elliottohmiller/tombus_3.0/README.md

# tombus_3.0
A barebones noisemaker with a focus on intuitive controls. 
tombus_3 0_model
