elliottohmiller/tombus_3.0/CAD outputs/tombus_box_drawing.pdf

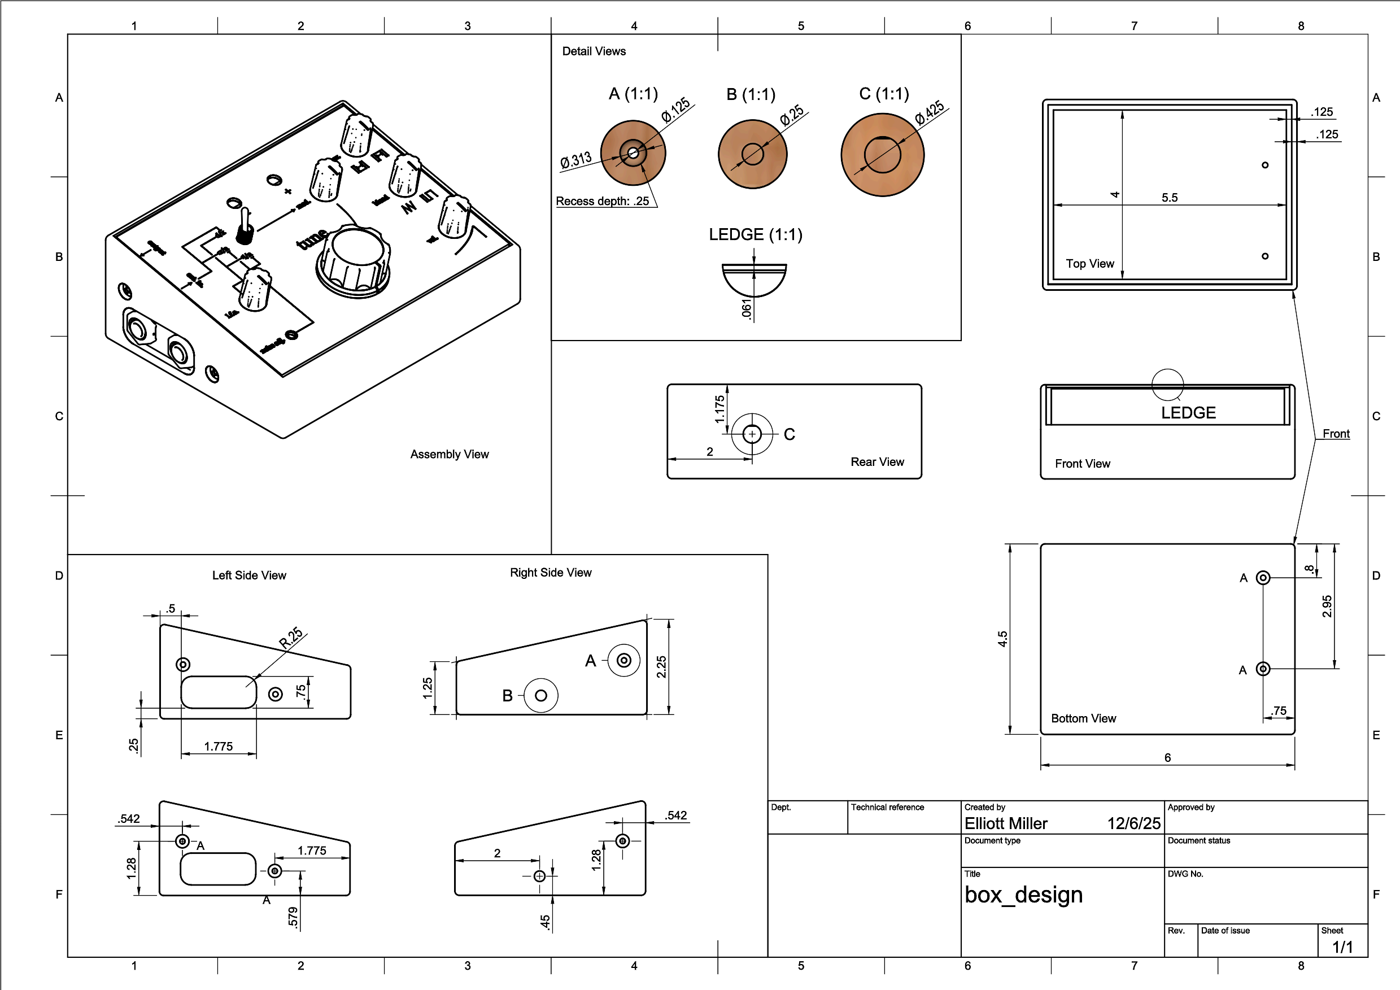
[picture p1: page 1]
