elliottohmiller/tombus_3.0/appNotes_and_dataSheets/Screenshot 2025-11-16 at 7.06.22 PM.png

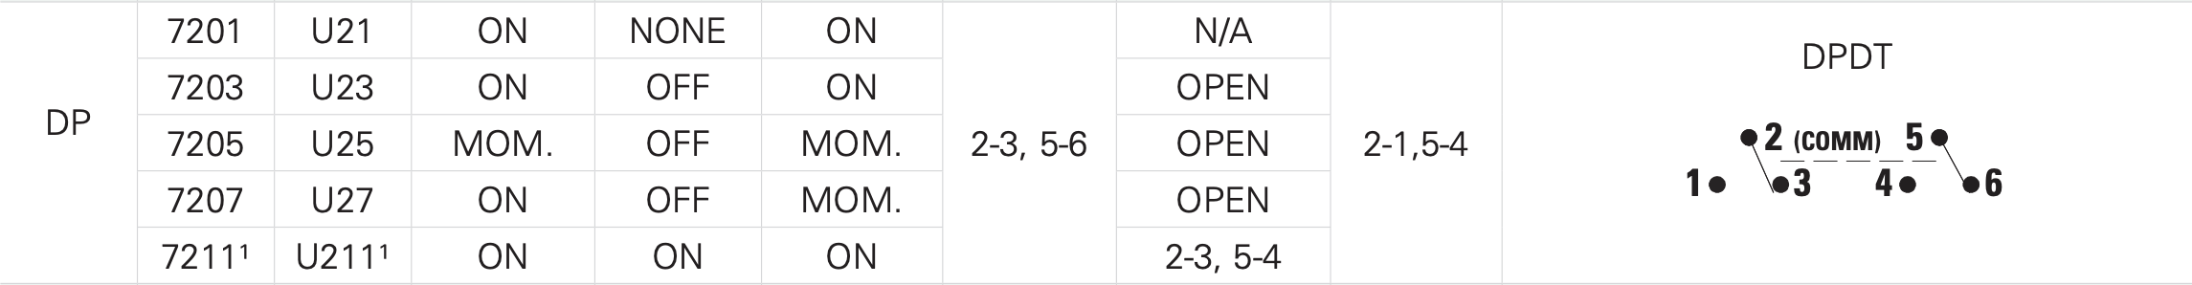
appNotes_and_dataSheets/Screenshot 2025-11-16 at 7.06.22 PM.png
