elliottohmiller/tombus_3.0/CAD outputs/tombus_3.0_model.png

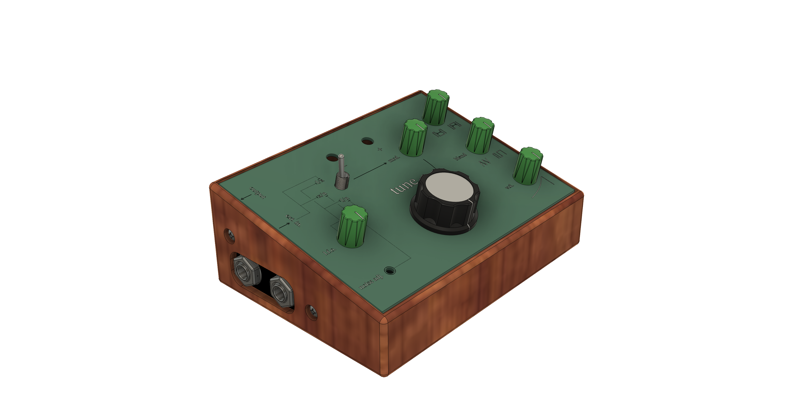
CAD outputs/tombus_3.0_model.png
