elliottohmiller/tombus_3.0/projectNotes/initial board constraints.png

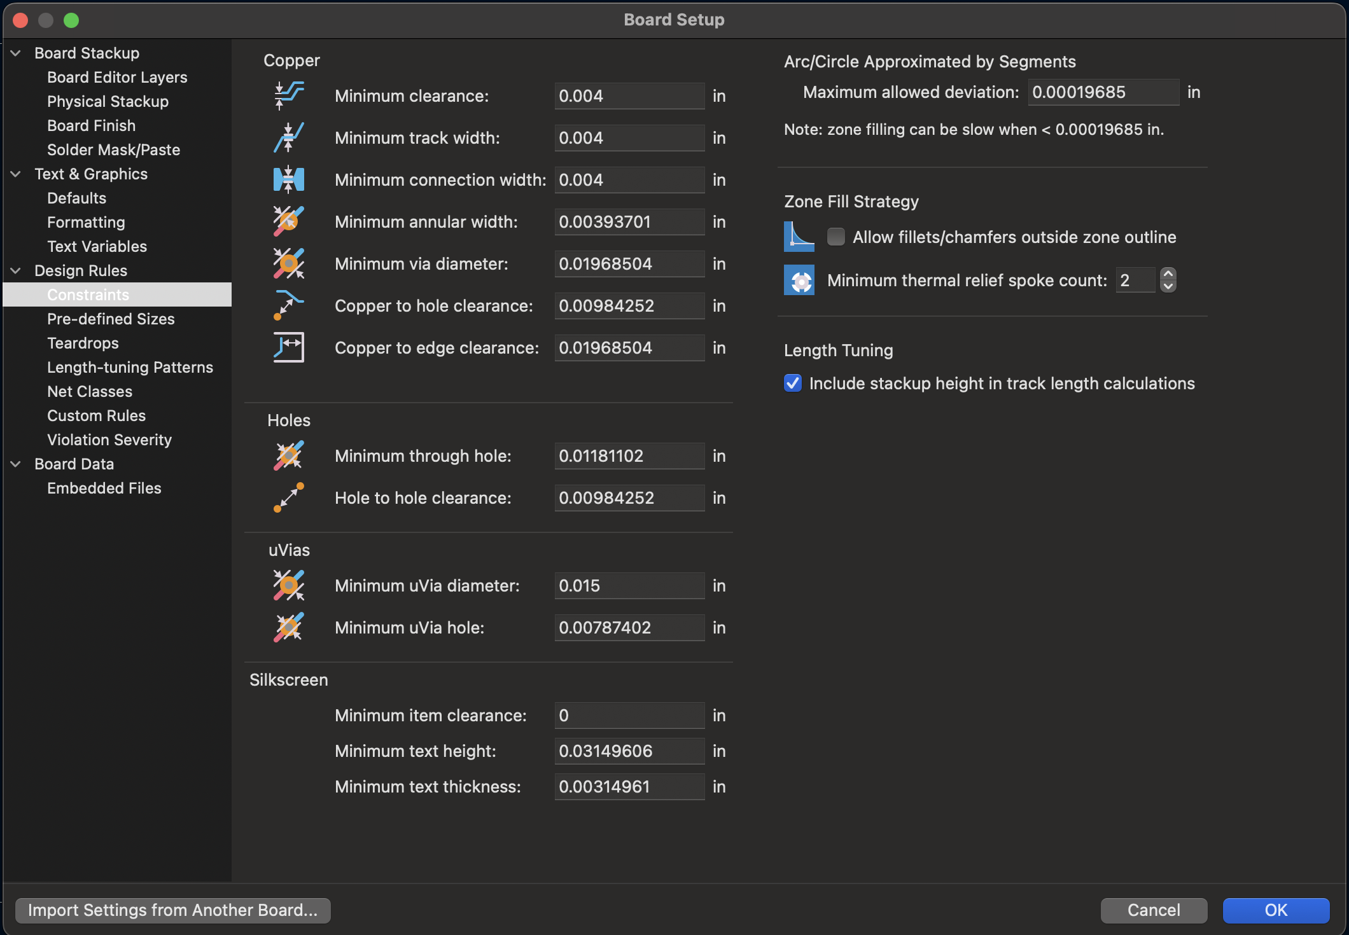
projectNotes/initial board constraints.png
