elliottohmiller/tombus_3.0/pdf_schematics/controlboard_init.pdf

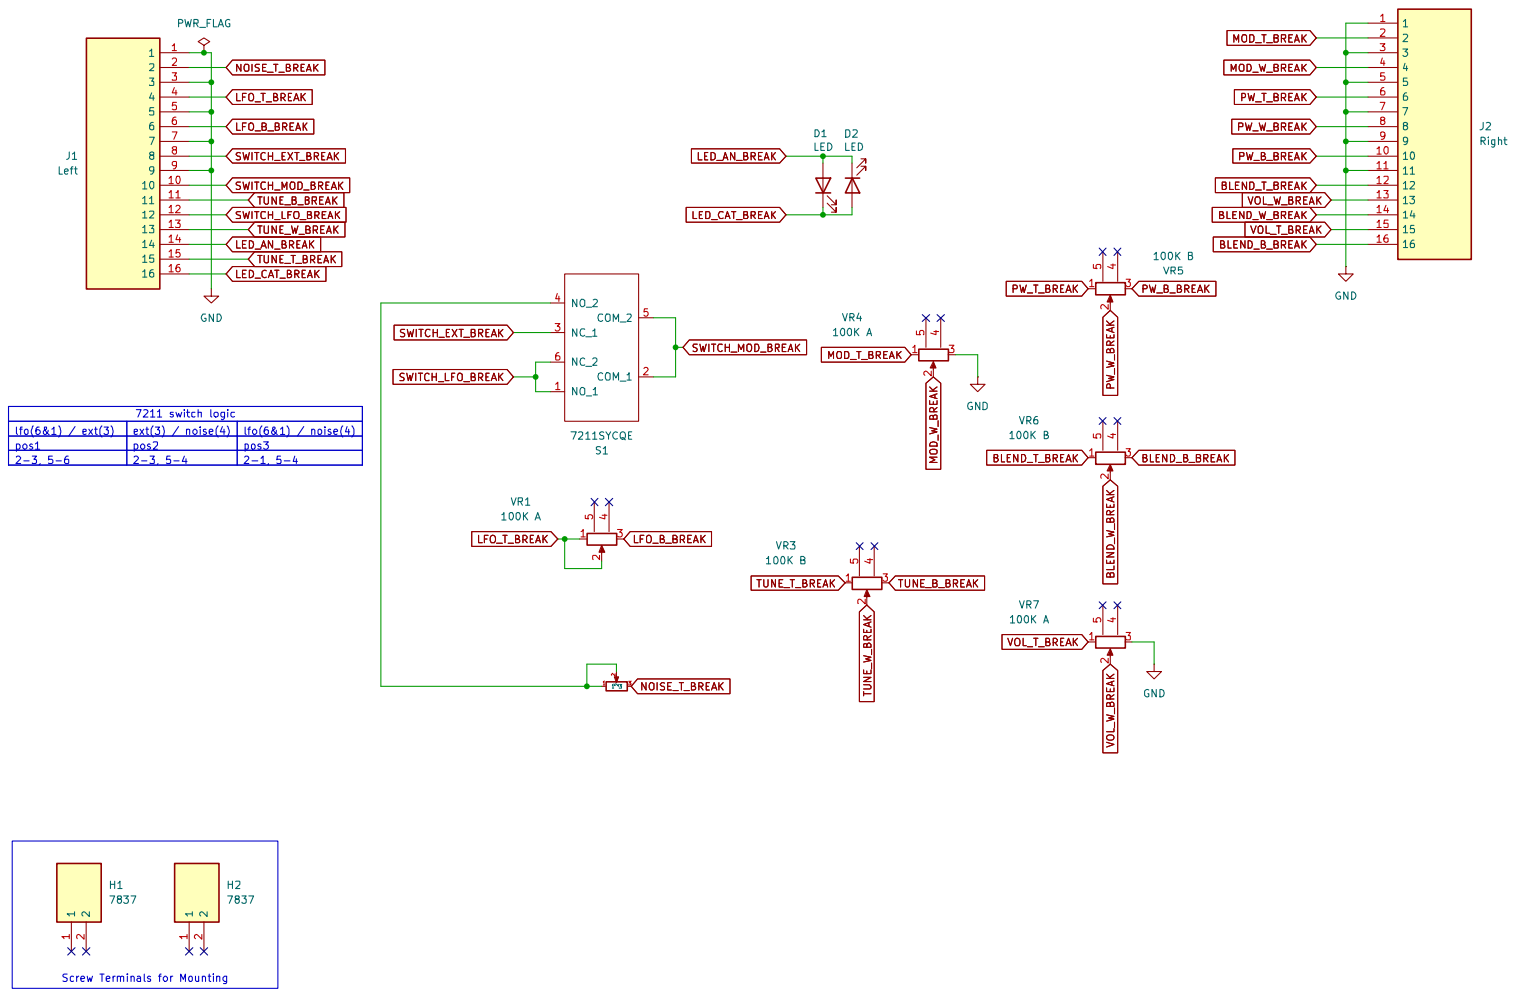
[picture p5: page 1]
