elliottohmiller/tombus_3.0/pdf_schematics/controlboard_pcb_init.pdf

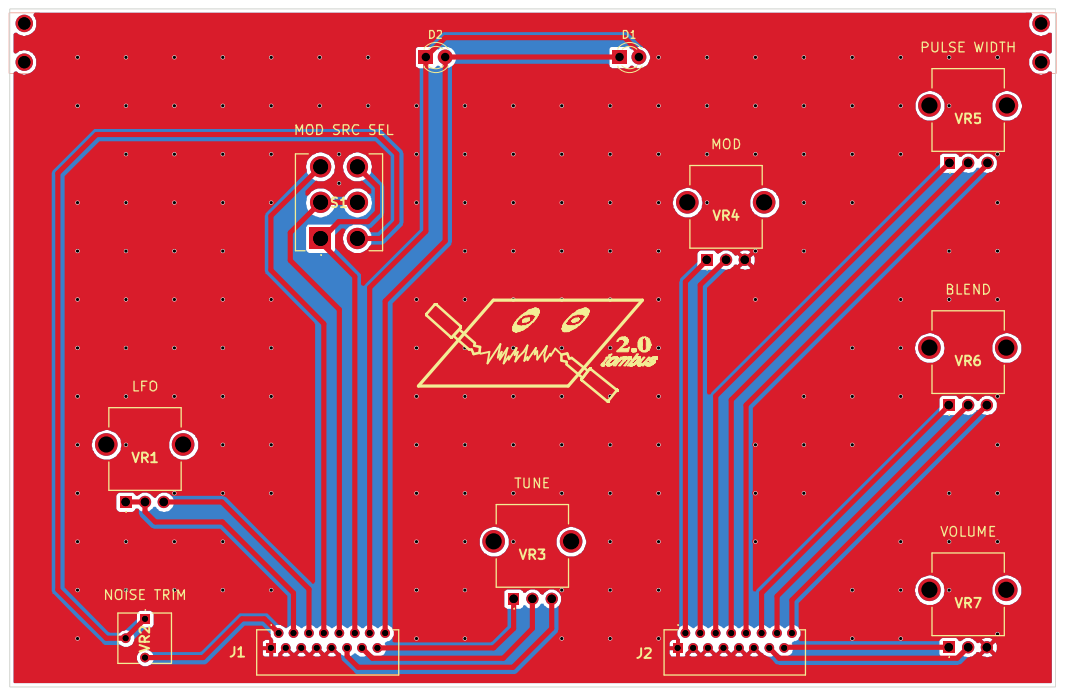
[picture p6: page 1]
