elliottohmiller/tombus_3.0/pdf_schematics/motherboard_pcb_init.pdf

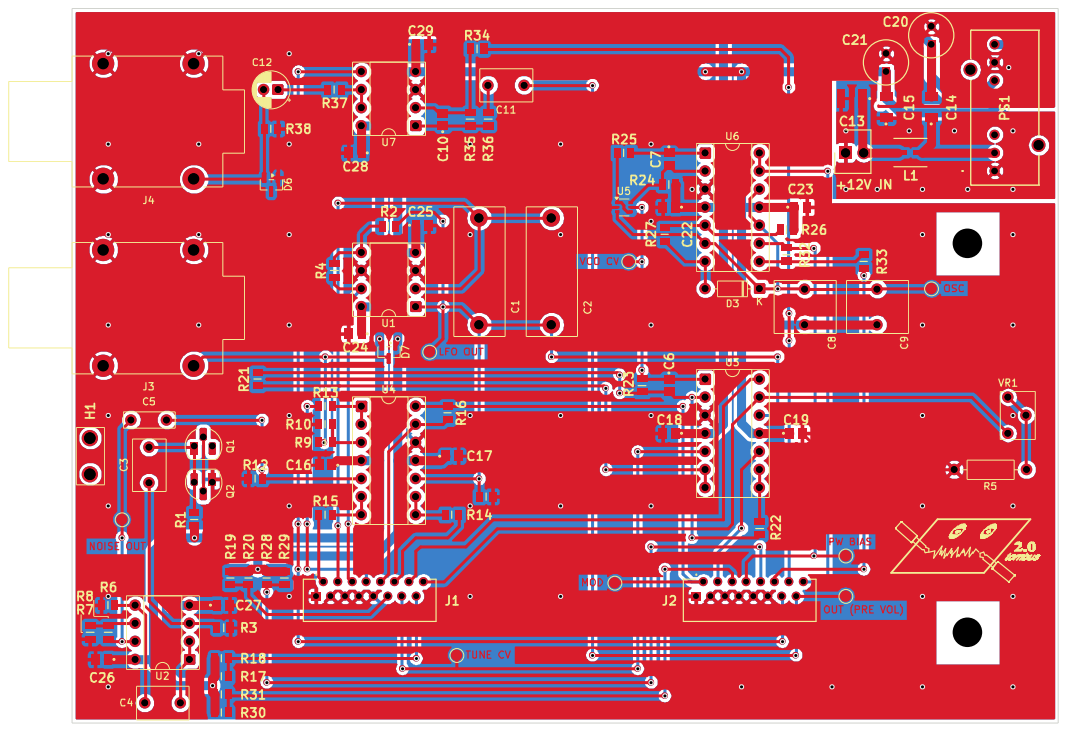
[picture p12: page 1]
