elliottohmiller/tombus_3.0/CAD outputs/tombus_2.0_front_panel.pdf

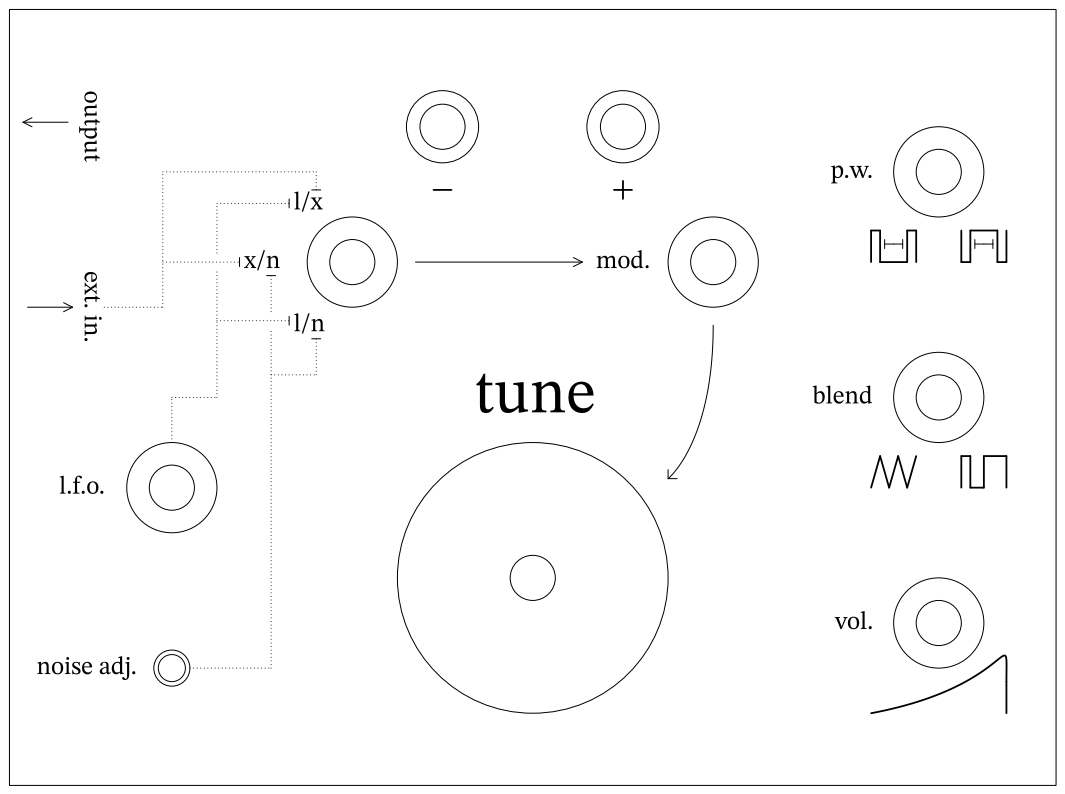
[picture p13: page 1]
