elliottohmiller/tombus_3.0/motherboard/motherboard.kicad_pcb

## KiCad design motherboard/motherboard.kicad_pcb (2026-02-08)

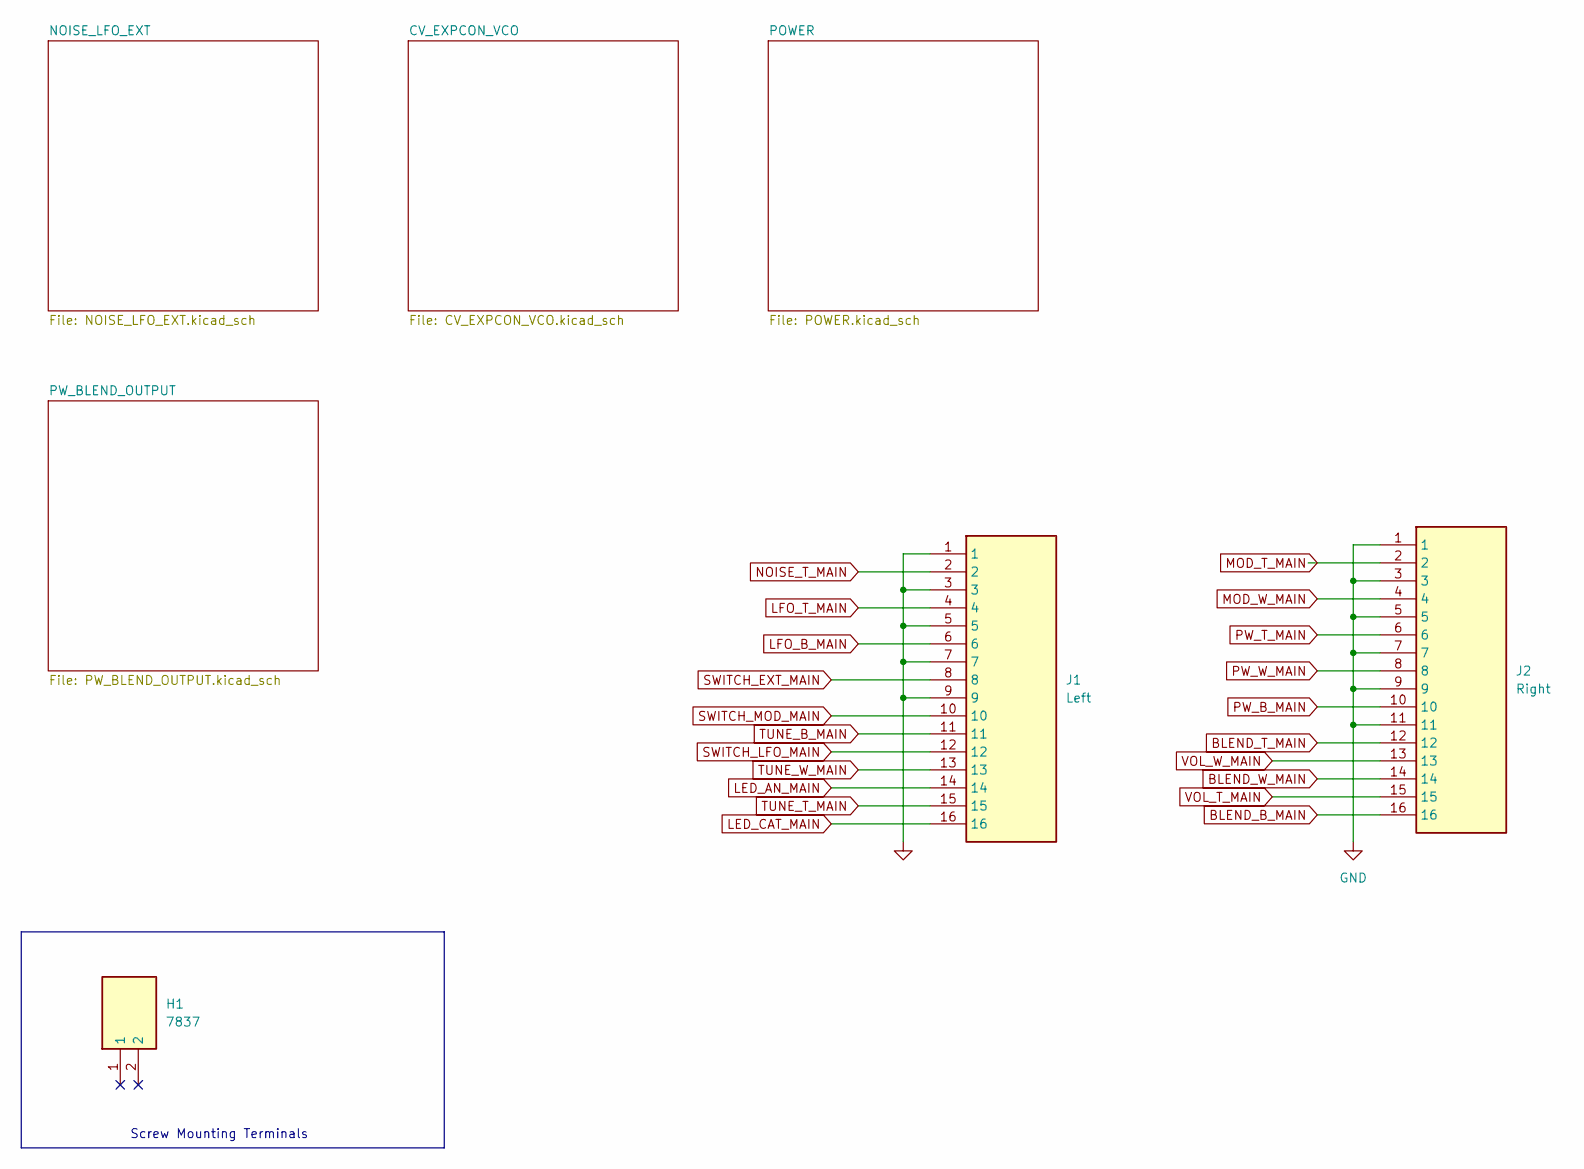
[picture p14: schematic motherboard.kicad_sch]

Parts:
H1: 7837; Mouser Part Number 534-7837
J1: Left; HLW16R2C7LF; Mouser Part Number 649-HLW16R-2C7LF
J2: Right; HLW16R2C7LF; Mouser Part Number 649-HLW16R-2C7LF

Connections:
BLEND_B_MAIN: J2.16; also elsewhere on the board
BLEND_T_MAIN: J2.12; also elsewhere on the board
BLEND_W_MAIN: J2.14; also elsewhere on the board
GND: J1.1, J1.3, J1.5, J1.7, J1.9, J2.1, J2.3, J2.5, J2.7, J2.9, J2.11; also elsewhere on the board
LED_AN_MAIN: J1.14; also elsewhere on the board
LED_CAT_MAIN: J1.16; also elsewhere on the board
LFO_B_MAIN: J1.6; also elsewhere on the board
LFO_T_MAIN: J1.4; also elsewhere on the board
MOD_T_MAIN: J2.2; also elsewhere on the board
MOD_W_MAIN: J2.4; also elsewhere on the board
NOISE_T_MAIN: J1.2; also elsewhere on the board
PW_B_MAIN: J2.10; also elsewhere on the board
PW_T_MAIN: J2.6; also elsewhere on the board
PW_W_MAIN: J2.8; also elsewhere on the board
SWITCH_EXT_MAIN: J1.8; also elsewhere on the board
SWITCH_LFO_MAIN: J1.12; also elsewhere on the board
SWITCH_MOD_MAIN: J1.10; also elsewhere on the board
TUNE_B_MAIN: J1.11; also elsewhere on the board
TUNE_T_MAIN: J1.15; also elsewhere on the board
TUNE_W_MAIN: J1.13; also elsewhere on the board
VOL_T_MAIN: J2.15; also elsewhere on the board
VOL_W_MAIN: J2.13; also elsewhere on the board

Notes on the sheet:
Screw Mounting Terminals

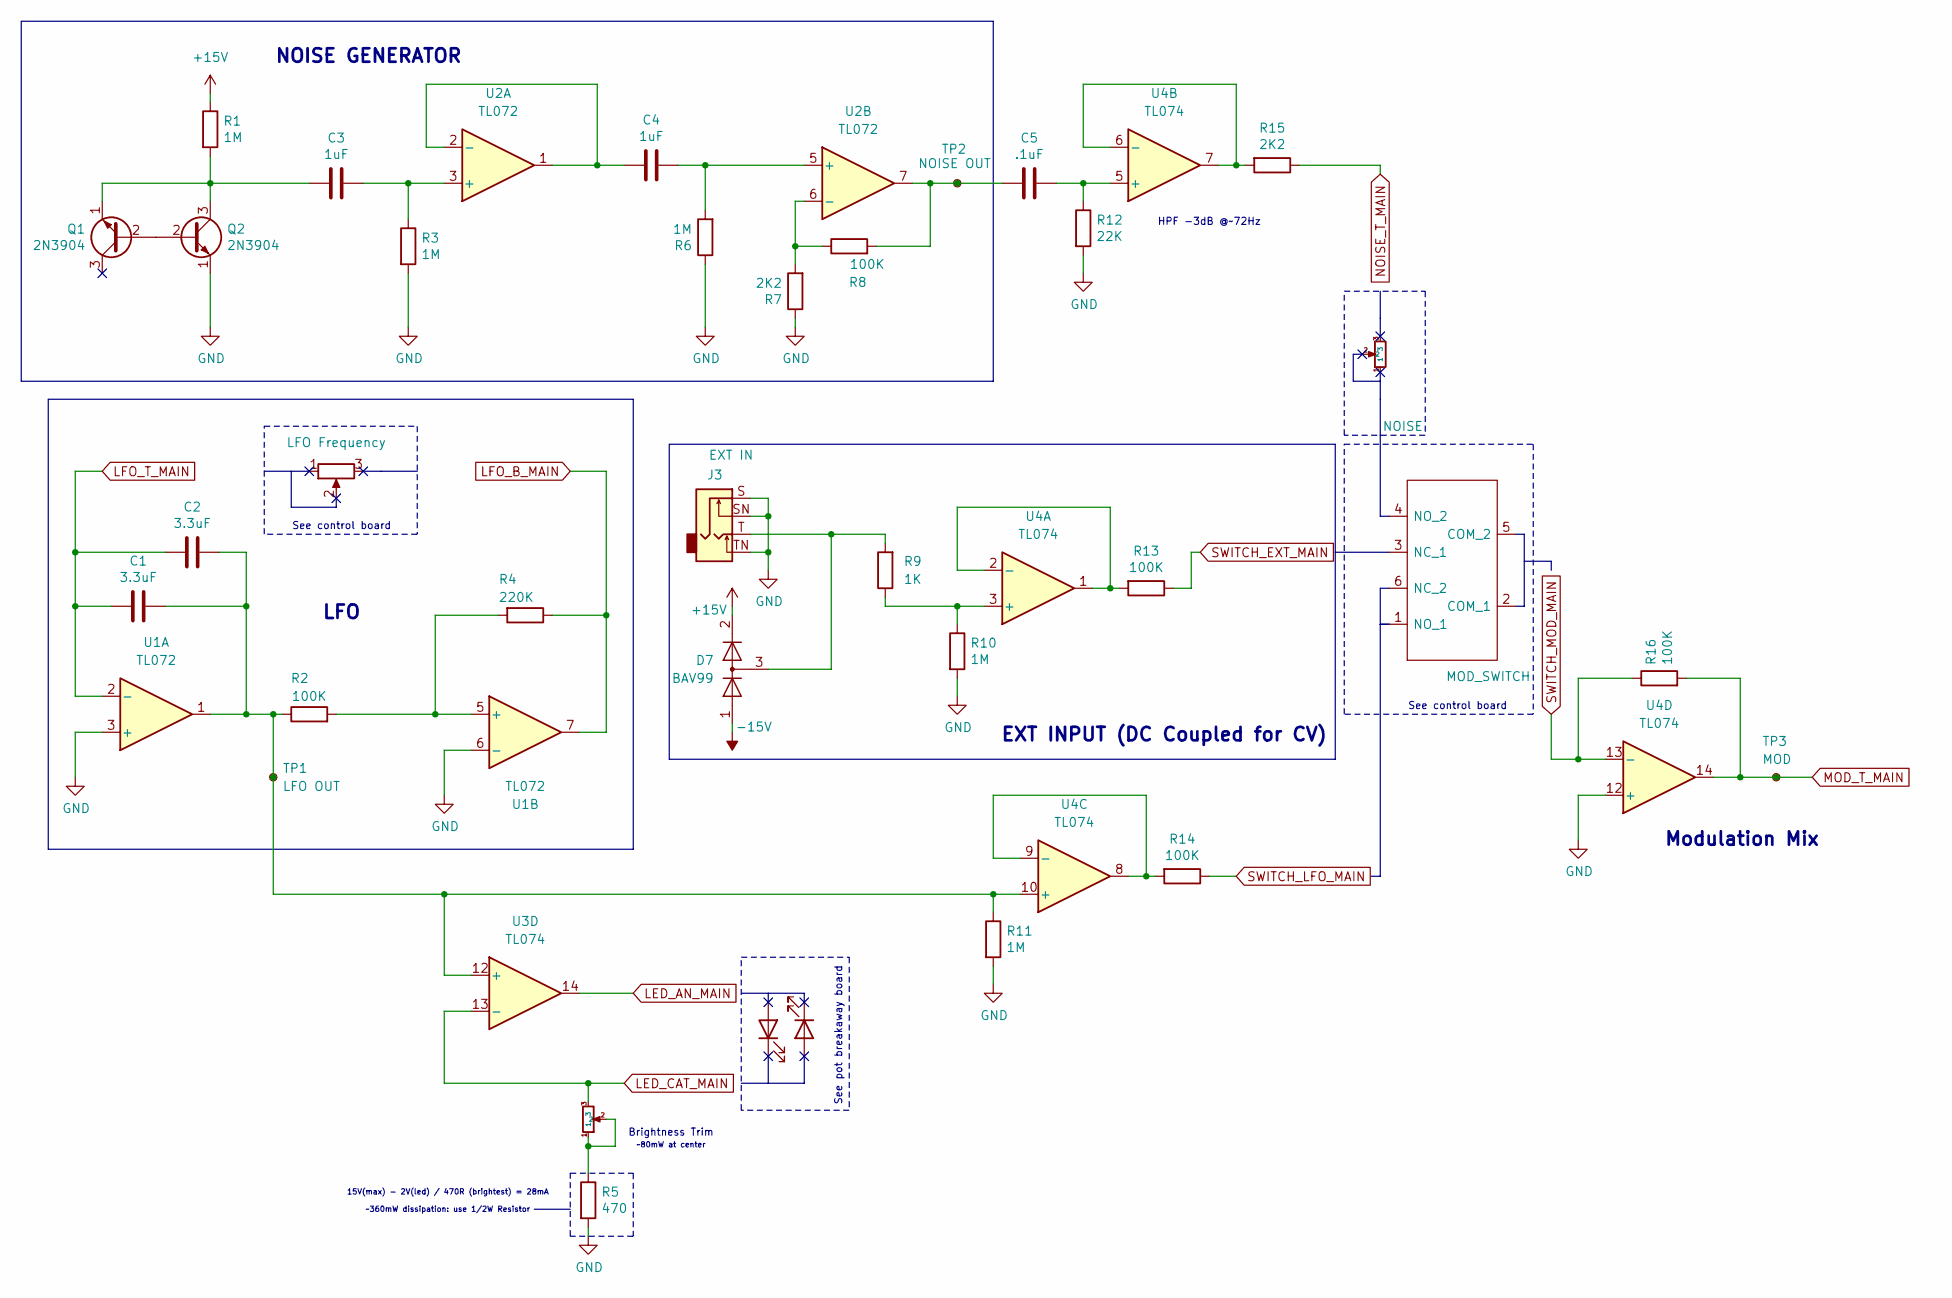
[picture p15: schematic NOISE_LFO_EXT.kicad_sch]

Parts:
C1, C2: 3.3uF; C_Rect_L18.0mm_W7.0mm_P15.00mm_FKS3_FKP3
C3, C4: 1uF; C_Rect_L7.2mm_W4.5mm_P5.00mm_FKS2_FKP2_MKS2_MKP2
C5: .1uF; C_Rect_L7.0mm_W2.0mm_P5.00mm
D1, D2: LFO F
D7: BAV99; SOT-23
J3: EXT IN; Jack_6.35mm_Neutrik_NMJ4HFD2_Horizontal
Q1, Q2: 2N3904; TO-92_HandSolder
R1, R3, R6, R10, R11: 1M; RESC2012X60N
R2, R8, R13, R14, R16: 100K; RESC2012X60N
R4: 220K; RESC2012X60N
R5: 470; R_Axial_DIN0207_L6.3mm_D2.5mm_P10.16mm_Horizontal
R7, R15: 2K2; RESC2012X60N
R9: 1K; RESC2012X60N
R12: 22K; RESC2012X60N
RV1: LFO Frequency
S1: MOD_SWITCH; 7211SYCQE; Mouser Part Number 611-7211-002
TP1: LFO OUT; TestPoint_Pad_D1.5mm
TP2: NOISE OUT; TestPoint_Pad_D1.5mm
TP3: MOD; TestPoint_Pad_D1.5mm
U1, U2: TL072; DIP-8_W7.62mm_Socket
U3, U4: TL074; DIP-14_W7.62mm_Socket
VR1: LED BRIGHTNESS; Potentiometer_Vishay_T73XX_Horizontal; Mouser Part Number 72-T70YP-10K
VR2: NOISE; T73YP103KT20; Mouser Part Number 72-T70YP-10K

Connections:
+15V: D7.2 (A), R1.1; also elsewhere on the board
-15V: D7.1 (K); also elsewhere on the board
GND: J3.S, J3.SN, J3.TN, Q2.1 (E), R3.2, R5.2, R6.1, R7.1, R10.2, R11.2, R12.2, U1.3 (+), U1.6 (-), U4.12 (+); also elsewhere on the board
LED_AN_MAIN: U3.14; also elsewhere on the board
LED_CAT_MAIN: U3.13 (-), VR1.3; also elsewhere on the board
LFO_B_MAIN: R4.1, U1.7; also elsewhere on the board
LFO_T_MAIN: C1.2, C2.2, U1.2 (-); also elsewhere on the board
MOD_T_MAIN: R16.2, TP3.1, U4.14; also elsewhere on the board
NOISE_T_MAIN: R15.1; also elsewhere on the board
unnamed: C5.2, R8.2, TP2.1, U2.7
unnamed: D7.3 (K), J3.T, R9.2
unnamed: Q1.2 (B), Q2.2 (B)
unnamed: C3.2, Q1.1 (E), Q2.3 (C), R1.2
unnamed: R5.1, VR1.1, VR1.2
unnamed: R2.2, R4.2, U1.5 (+)
unnamed: C3.1, R3.1, U2.3 (+)
unnamed: C4.2, U2.1, U2.2 (-)
unnamed: C4.1, R6.2, U2.5 (+)
unnamed: R7.2, R8.1, U2.6 (-)
unnamed: C1.1, C2.1, R2.1, R11.1, TP1.1, U1.1, U3.12 (+), U4.10 (+)
unnamed: R9.1, R10.1, U4.3 (+)
unnamed: R13.2, U4.1, U4.2 (-)
unnamed: C5.1, R12.1, U4.5 (+)
unnamed: R15.2, U4.6 (-), U4.7
unnamed: R14.2, U4.8, U4.9 (-)
SWITCH_EXT_MAIN: R13.1; also elsewhere on the board
SWITCH_LFO_MAIN: R14.1; also elsewhere on the board
SWITCH_MOD_MAIN: R16.1, U4.13 (-); also elsewhere on the board

Notes on the sheet:
Brightness Trim
NOISE GENERATOR
LFO
15V(max) - 2V(led) / 470R (brightest) = 28mA ~360mW dissipation: use 1/2W Resistor
See control board
See pot breakaway board
~80mW at center
HPF -3dB @~72Hz
EXT INPUT (DC Coupled for CV)
Modulation Mix

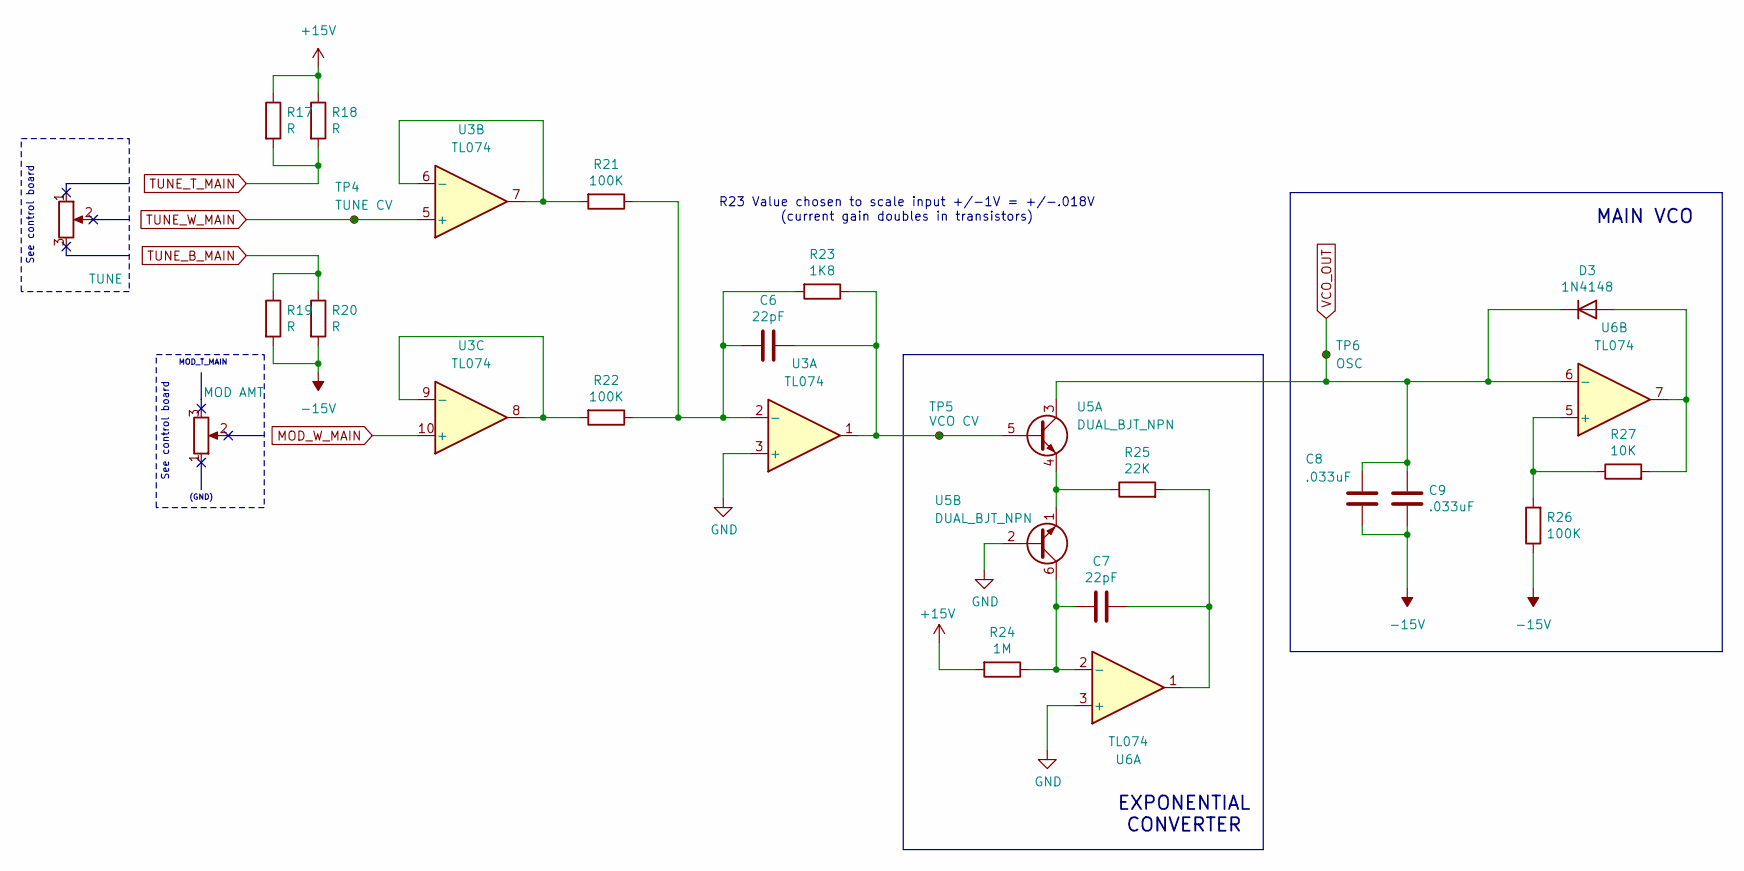
[picture p16: schematic CV_EXPCON_VCO.kicad_sch]

Parts:
C6, C7: 22pF; C0805
C8, C9: .033uF; C_Rect_L7.2mm_W8.5mm_P5.00mm_FKP2_FKP2_MKS2_MKP2
D3: 1N4148; D_DO-35_SOD27_P7.62mm_Horizontal
R17, R18, R19, R20: R; RESC2012X60N
R21, R22, R26: 100K; RESC2012X60N
R23: 1K8; RESC2012X60N
R24: 1M; RESC2012X60N
R25: 22K; RESC2012X60N
R27: 10K; RESC2012X60N
RV2: TUNE
RV3: MOD AMT
TP4: TUNE CV; TestPoint_Pad_D1.5mm
TP5: VCO CV; TestPoint_Pad_D1.5mm
TP6: OSC; TestPoint_Pad_D1.5mm
U3, U6: TL074; DIP-14_W7.62mm_Socket
U5: DUAL_BJT_NPN; SOT-363_SC-70-6

Connections:
+15V: R17.1, R18.1, R24.2; also elsewhere on the board
-15V: C8.1, C9.1, R19.2, R20.2, R26.1; also elsewhere on the board
GND: U3.3 (+), U5.2 (B1), U6.3 (+); also elsewhere on the board
MOD_W_MAIN: U3.10 (+); also elsewhere on the board
unnamed: C7.1, R25.2, U6.1
unnamed: D3.2 (A), R27.2, U6.7
unnamed: C6.2, R21.1, R22.1, R23.2, U3.2 (-)
unnamed: R21.2, U3.6 (-), U3.7
unnamed: R22.2, U3.8, U3.9 (-)
unnamed: C6.1, R23.1, TP5.1, U3.1, U5.5 (B2)
unnamed: R25.1, U5.1 (E2), U5.4 (E1)
unnamed: C7.2, R24.1, U5.6 (C2), U6.2 (-)
unnamed: R26.2, R27.1, U6.5 (+)
TUNE_B_MAIN: R19.1, R20.1; also elsewhere on the board
TUNE_T_MAIN: R17.2, R18.2; also elsewhere on the board
TUNE_W_MAIN: TP4.1, U3.5 (+); also elsewhere on the board
VCO_OUT: C8.2, C9.2, D3.1 (K), TP6.1, U5.3 (C1), U6.6 (-); also elsewhere on the board

Notes on the sheet:
See control board
MOD_T_MAIN
R23 Value chosen to scale input +/-1V = +/-.018V (current gain doubles in transistors)
MAIN VCO
EXPONENTIAL CONVERTER
(GND)

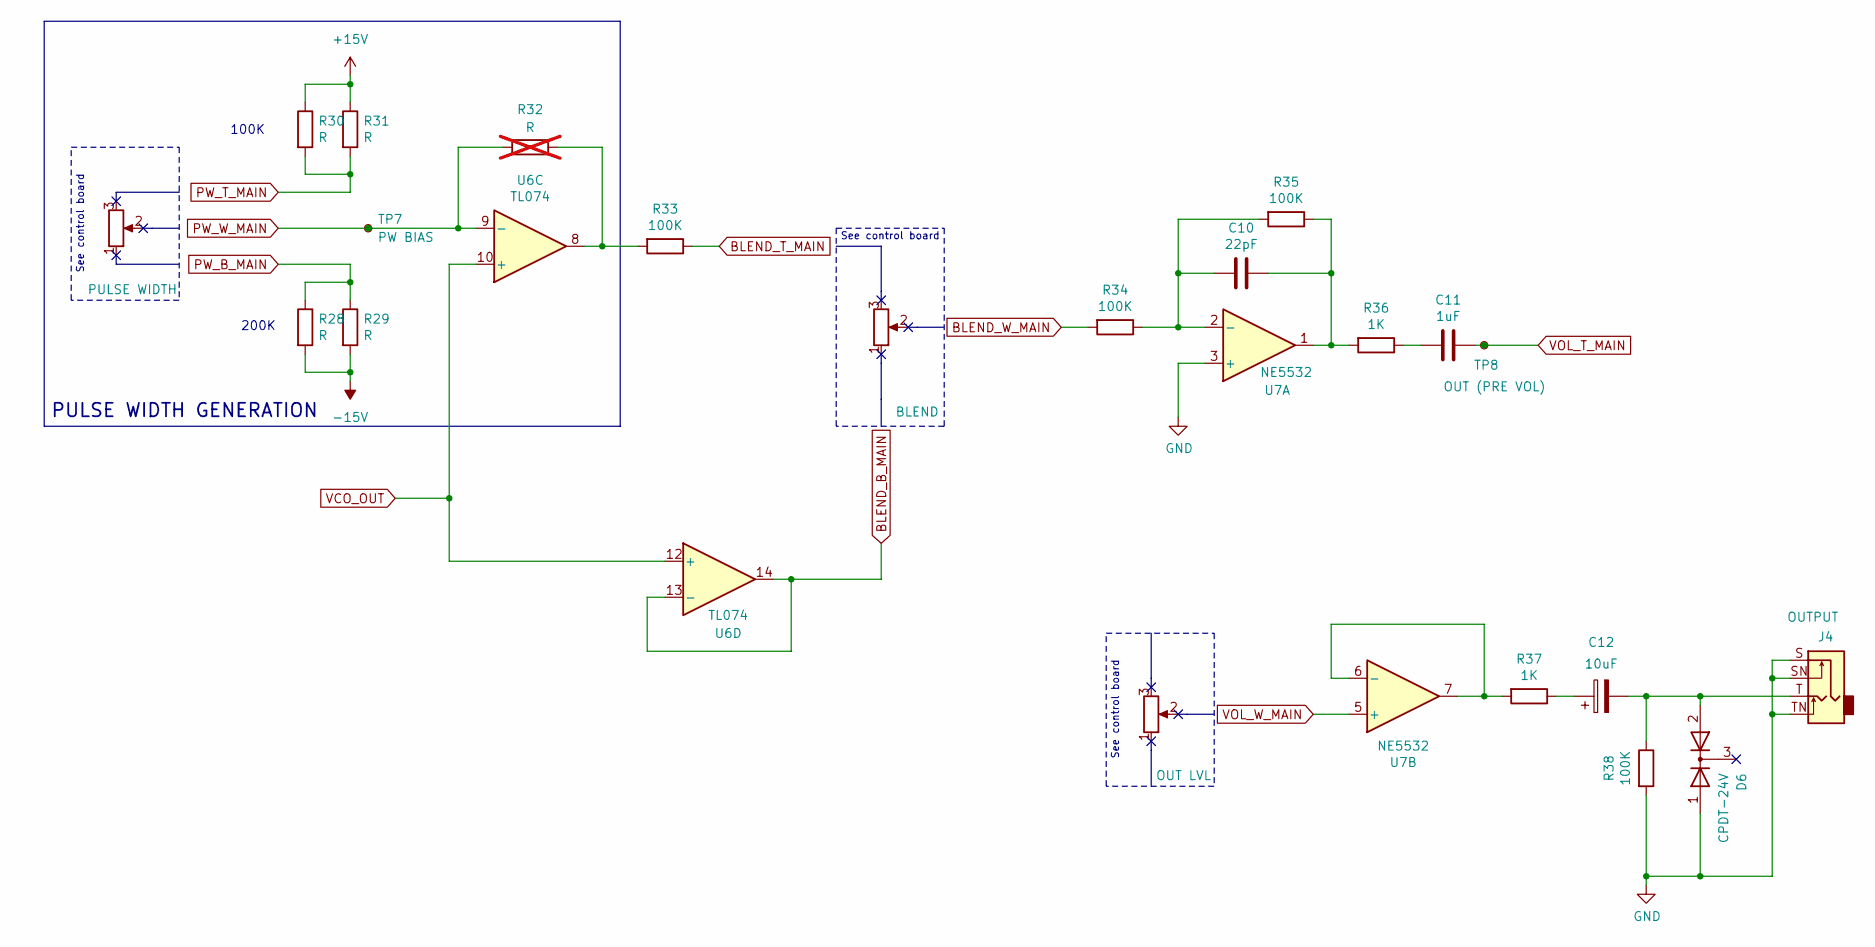
[picture p17: schematic PW_BLEND_OUTPUT.kicad_sch]

Parts:
C10: 22pF; C0805
C11: 1uF; C_Rect_L7.2mm_W4.5mm_P5.00mm_FKS2_FKP2_MKS2_MKP2
C12: 10uF; CP_Radial_D5.0mm_P2.00mm
D6: CPDT-24V; SOT-23
J4: OUTPUT; Jack_6.35mm_Neutrik_NMJ4HFD2_Horizontal
R28, R29, R30, R31: R; RESC2012X60N
R32: R; RESC2012X60N; not fitted
R33, R34, R35, R38: 100K; RESC2012X60N
R36, R37: 1K; RESC2012X60N
RV4: PULSE WIDTH
RV5: BLEND
RV6: OUT LVL
TP7: PW BIAS; TestPoint_Pad_D1.5mm
TP8: OUT (PRE VOL); TestPoint_Pad_D1.5mm
U6: TL074; DIP-14_W7.62mm_Socket
U7: NE5532; DIP-8_W7.62mm_Socket

Connections:
+15V: R30.1, R31.1; also elsewhere on the board
-15V: R28.2, R29.2; also elsewhere on the board
BLEND_B_MAIN: U6.13 (-), U6.14; also elsewhere on the board
BLEND_T_MAIN: R33.1; also elsewhere on the board
BLEND_W_MAIN: R34.2; also elsewhere on the board
GND: D6.1 (A), J4.S, J4.SN, J4.TN, R38.2, U7.3 (+); also elsewhere on the board
unnamed: C10.1, R35.1, R36.2, U7.1
unnamed: C11.2, R36.1
unnamed: C12.1, R37.1
unnamed: C12.2, D6.2 (A), J4.T, R38.1
unnamed: R32.2, R33.2, U6.8
unnamed: C10.2, R34.1, R35.2, U7.2 (-)
unnamed: R37.2, U7.6 (-), U7.7
PW_B_MAIN: R28.1, R29.1; also elsewhere on the board
PW_T_MAIN: R30.2, R31.2; also elsewhere on the board
PW_W_MAIN: R32.1, TP7.1, U6.9 (-); also elsewhere on the board
VCO_OUT: U6.10 (+), U6.12 (+); also elsewhere on the board
VOL_T_MAIN: C11.1, TP8.1; also elsewhere on the board
VOL_W_MAIN: U7.5 (+); also elsewhere on the board

Notes on the sheet:
See control board
200K
100K
PULSE WIDTH GENERATION

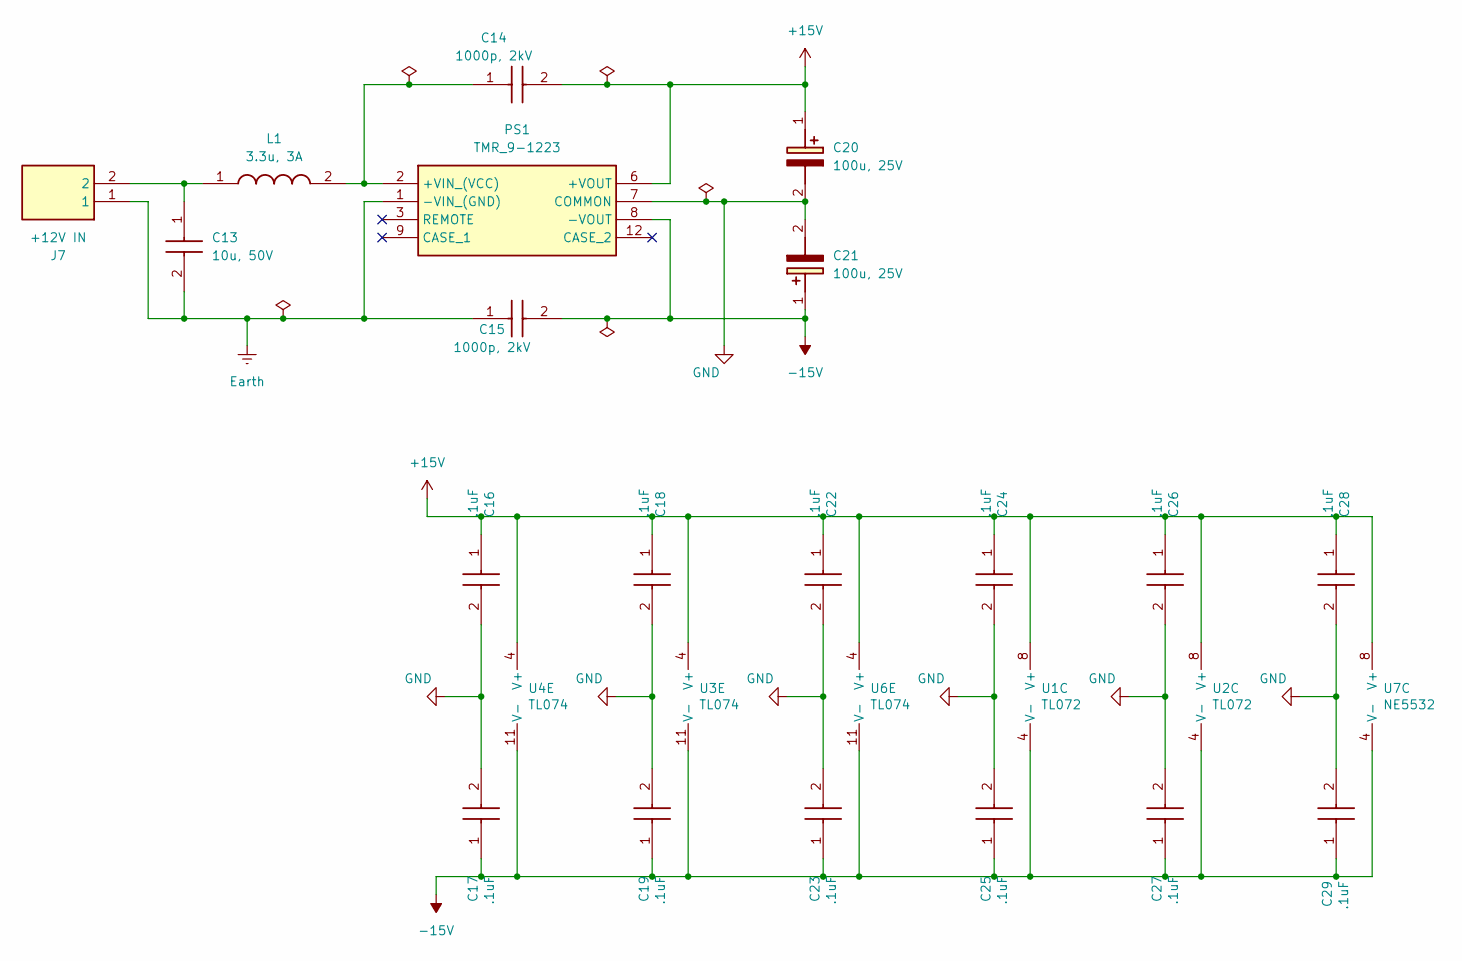
[picture p18: schematic POWER.kicad_sch]

Parts:
C13: 10u, 50V; C1210; Mouser Part Number 80-C1210C106M5R
C14, C15: 1000p, 2kV; C1206; Mouser Part Number 80-C1206C102JGR
C16, C17, C18, C19, C22, C23, C24, C25, C26, C27, C28, C29: .1uF; C0805; Mouser Part Number 80-C0805C104K1R
C20, C21: 100u, 25V; CAPPRD250W55D630H1350; Mouser Part Number 581-RES0611101M025B
J7: +12V IN; SHDR2W66P0X254_1X2_508X572X1041P; Mouser Part Number 571-6404562
L1: 3.3u, 3A; INDPM4740X210N; Mouser Part Number 495-TCK-108
PS1: TMR_9-1223; TMR92411; Mouser Part Number 495-TMR9-1223
U1, U2: TL072; DIP-8_W7.62mm_Socket
U3, U4, U6: TL074; DIP-14_W7.62mm_Socket
U7: NE5532; DIP-8_W7.62mm_Socket

Connections:
+15V: C14.2, C16.1, C18.1, C20.1 (+), C22.1, C24.1, C26.1, C28.1, PS1.6 (+VOUT), U1.8 (V+), U2.8 (V+), U3.4 (V+), U4.4 (V+), U6.4 (V+), U7.8 (V+); also elsewhere on the board
-15V: C15.2, C17.1, C19.1, C21.1 (+), C23.1, C25.1, C27.1, C29.1, PS1.8 (-VOUT), U1.4 (V-), U2.4 (V-), U3.11 (V-), U4.11 (V-), U6.11 (V-), U7.4 (V-); also elsewhere on the board
Earth: C13.2, C15.1, J7.1, PS1.1 (-VIN_(GND))
GND: C16.2, C17.2, C18.2, C19.2, C20.2 (-), C21.2 (-), C22.2, C23.2, C24.2, C25.2, C26.2, C27.2, C28.2, C29.2, PS1.7 (COMMON); also elsewhere on the board
unnamed: C13.1, J7.2, L1.1
unnamed: C14.1, L1.2, PS1.2 (+VIN_(VCC))

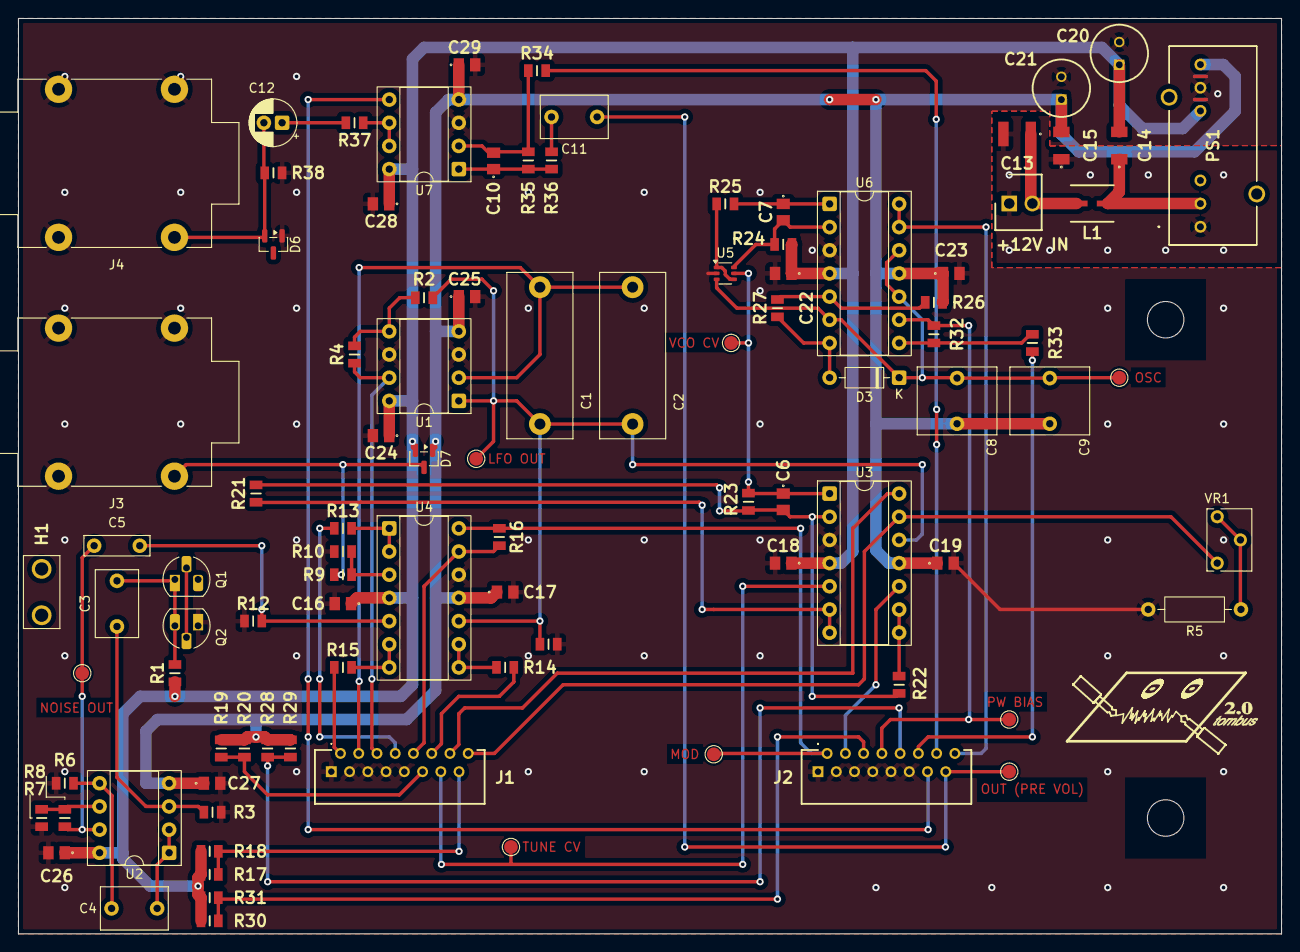
[picture p19: board motherboard.kicad_pcb from above]

Board: 2 copper layers, 138.4 x 100.3 mm, 96 parts (0 on the bottom side), 60 nets.
