elliottohmiller/tombus_3.0/controlboard/controlboard.kicad_pcb

## KiCad design controlboard/controlboard.kicad_pcb (2026-02-08)

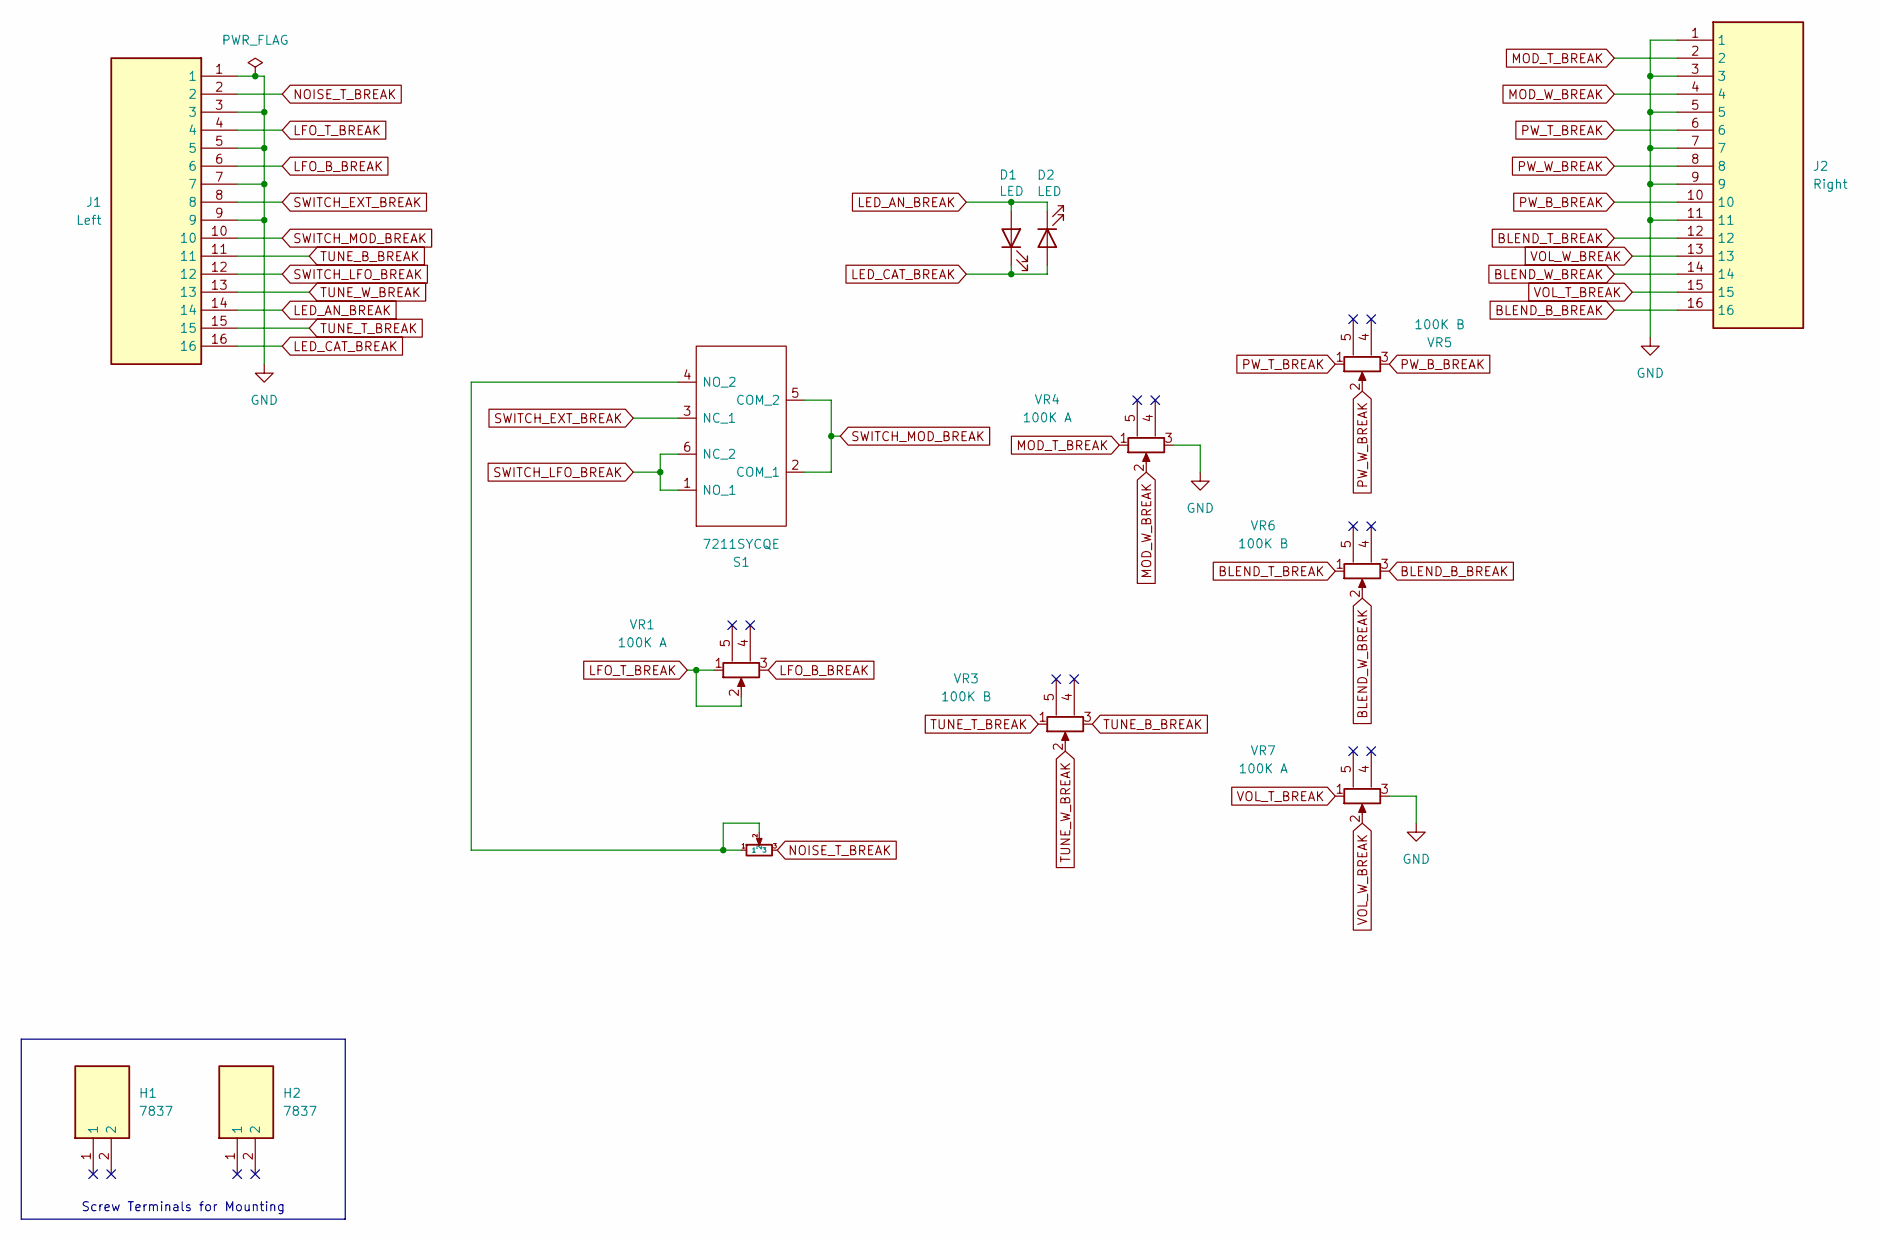
[picture p20: schematic controlboard.kicad_sch]

Parts:
D1, D2: LED; LED_D3.0mm_Clear
H1, H2: 7837; Mouser Part Number 534-7837
J1: Left; HLW16R2C7LF; Mouser Part Number 649-HLW16R-2C7LF
J2: Right; HLW16R2C7LF; Mouser Part Number 649-HLW16R-2C7LF
S1: 7211SYCQE; Mouser Part Number 611-7211-002
VR1, VR4, VR7: 100K A; PTN091V100115K1A; Manufacturer_Part_Number PTN091-V100115K1A
VR2: T73YP103KT20; Mouser Part Number 72-T70YP-10K
VR3, VR5, VR6: 100K B; PTN091V100115K1B; Manufacturer_Part_Number PTN091-V100115K1B

Connections:
BLEND_B_BREAK: J2.16, VR6.3
BLEND_T_BREAK: J2.12, VR6.1
BLEND_W_BREAK: J2.14, VR6.2
GND: J1.1, J1.3, J1.5, J1.7, J1.9, J2.1, J2.3, J2.5, J2.7, J2.9, J2.11, VR4.3, VR7.3
LED_AN_BREAK: D1.2 (A), D2.1 (K), J1.14
LED_CAT_BREAK: D1.1 (K), D2.2 (A), J1.16
LFO_B_BREAK: J1.6, VR1.3
LFO_T_BREAK: J1.4, VR1.1, VR1.2
MOD_T_BREAK: J2.2, VR4.1
MOD_W_BREAK: J2.4, VR4.2
NOISE_T_BREAK: J1.2, VR2.3
unnamed: S1.4 (NO_2), VR2.1, VR2.2
PW_B_BREAK: J2.10, VR5.3
PW_T_BREAK: J2.6, VR5.1
PW_W_BREAK: J2.8, VR5.2
SWITCH_EXT_BREAK: J1.8, S1.3 (NC_1)
SWITCH_LFO_BREAK: J1.12, S1.1 (NO_1), S1.6 (NC_2)
SWITCH_MOD_BREAK: J1.10, S1.2 (COM_1), S1.5 (COM_2)
TUNE_B_BREAK: J1.11, VR3.3
TUNE_T_BREAK: J1.15, VR3.1
TUNE_W_BREAK: J1.13, VR3.2
VOL_T_BREAK: J2.15, VR7.1
VOL_W_BREAK: J2.13, VR7.2

Notes on the sheet:
Screw Terminals for Mounting

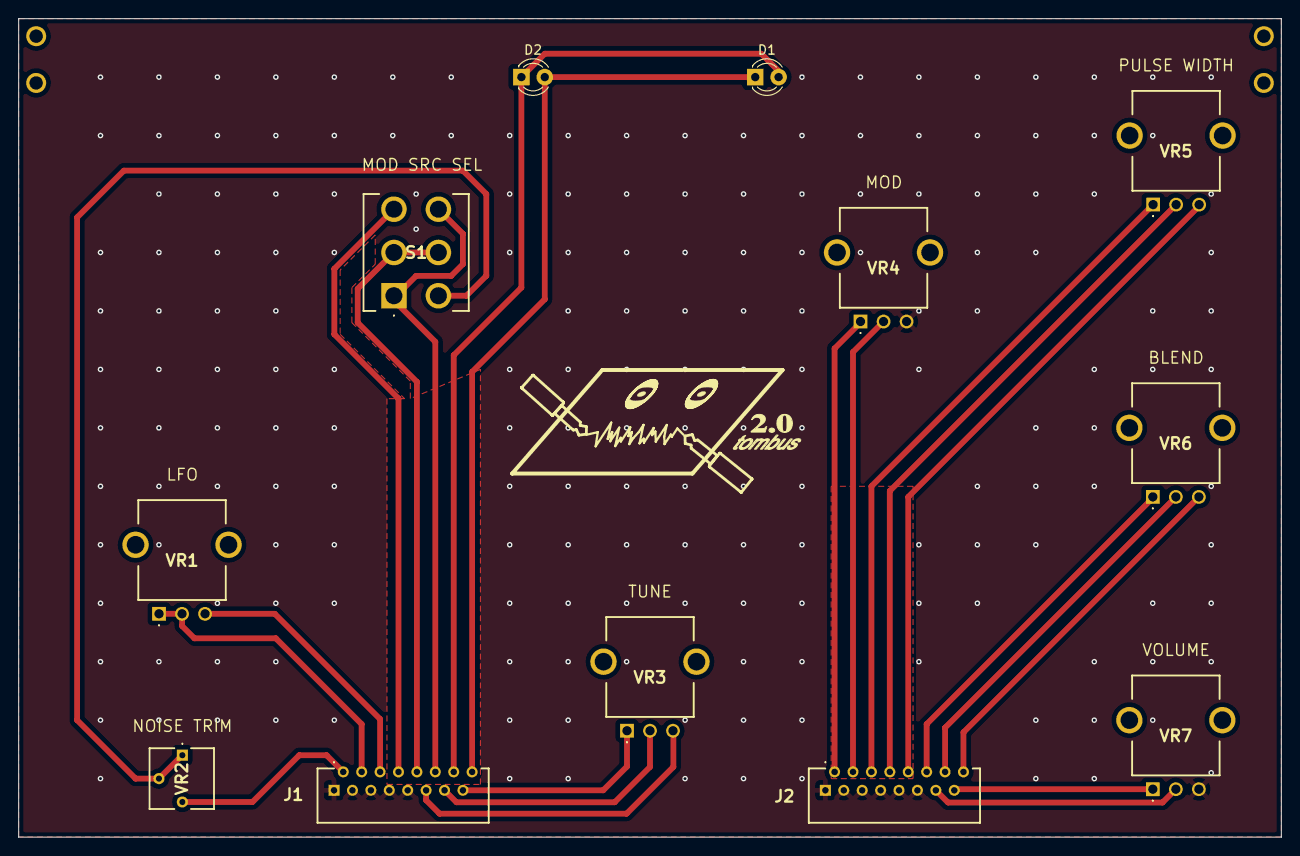
[picture p21: board controlboard.kicad_pcb from above]

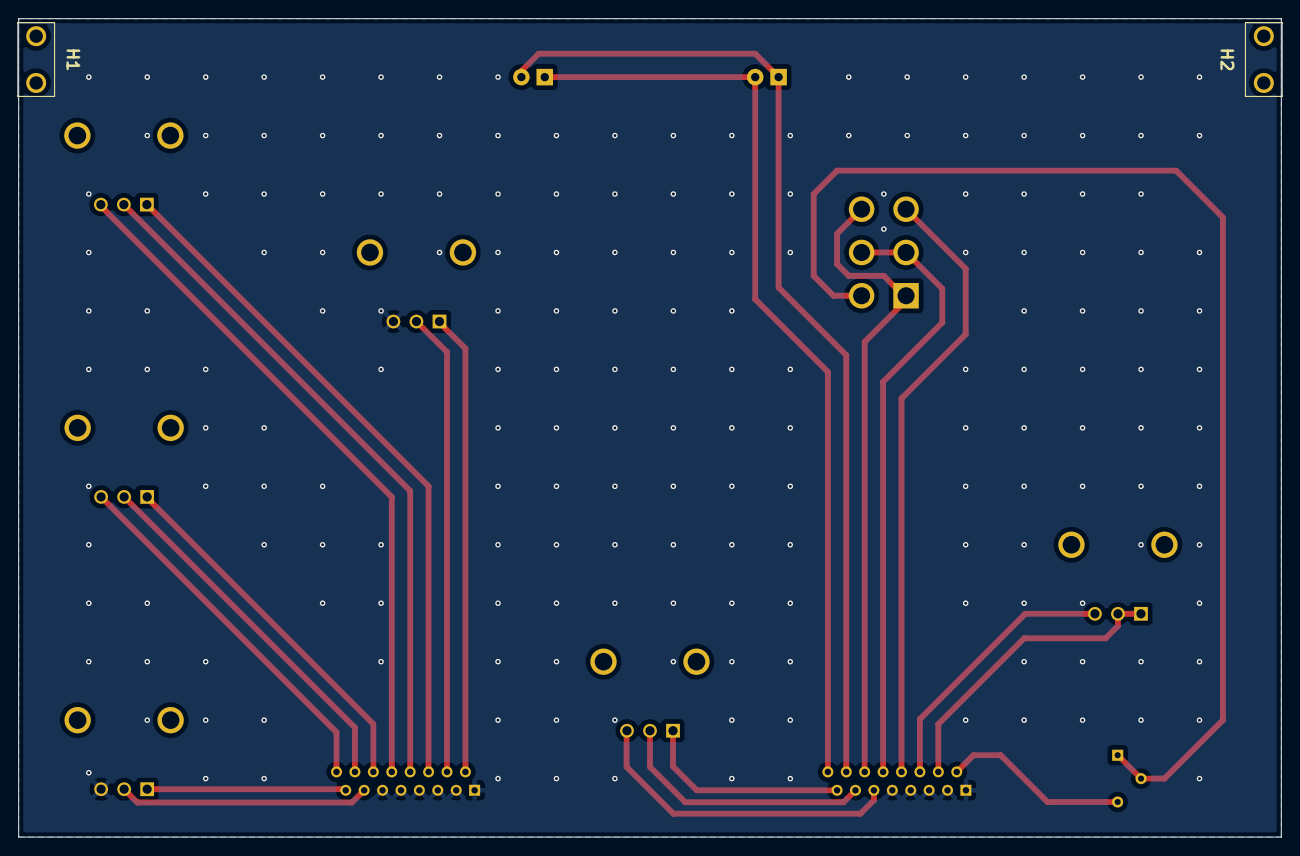
[picture p22: board controlboard.kicad_pcb from below]

Board: 2 copper layers, 137.2 x 88.9 mm, 14 parts (2 on the bottom side), 23 nets.
