elliottohmiller/tombus_3.0/(commit log)

2026-02-08 remove motherboard as submodule
    [CV_EXPCON_VCO.kicad_sch, NOISE_LFO_EXT.kicad_sch, POT_BREAKAWAY.kicad_sch, POWER.kicad_sch, PW_BLEND_OUTPUT.kicad_sch, motherboard.csv, motherboard.kicad_pcb, motherboard.kicad_sch]
2026-02-08 add model to CAD outputs
